steewbsd/Sichergo/docs/Sichergo.jpg

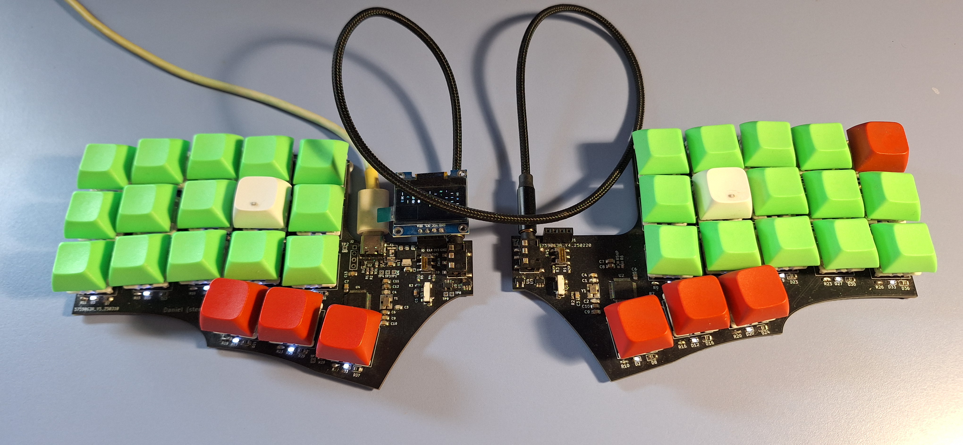
docs/Sichergo.jpg
