steewbsd/Sichergo/std/prot-right.dxf

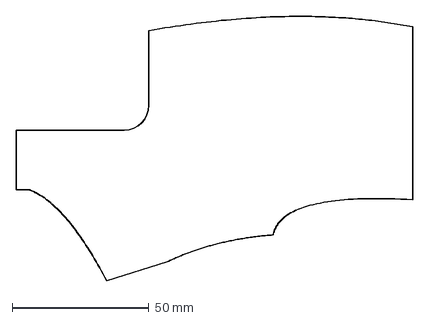
[picture p2: CAD file, 2025-11-02]
std/prot-right.dxf
144.7 x 96.5 mm
