steewbsd/Sichergo/std/prot-left.dxf

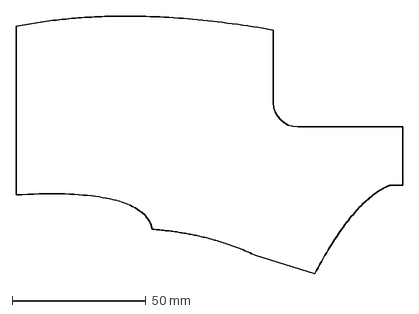
[picture p3: CAD file, 2025-11-02]
std/prot-left.dxf
144.7 x 96.5 mm
