steewbsd/Sichergo/std/sichergo-right.dxf

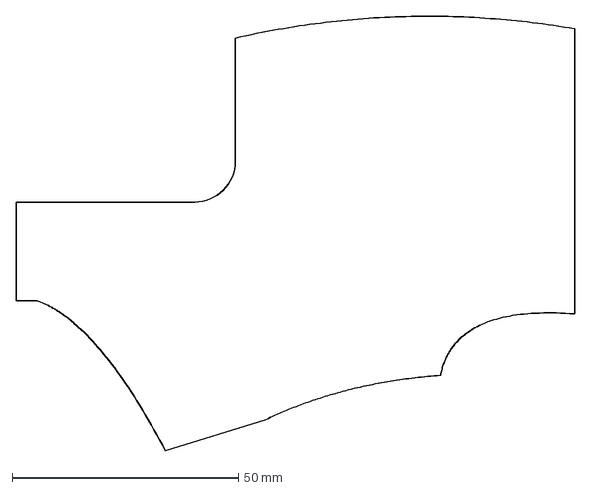
[picture p4: CAD file, 2025-11-02]
std/sichergo-right.dxf
123.4 x 96.1 mm
