steewbsd/Sichergo/sichergo-right/sichergo-right.kicad_pcb

## KiCad design sichergo-right/sichergo-right.kicad_pcb (2025-11-02)

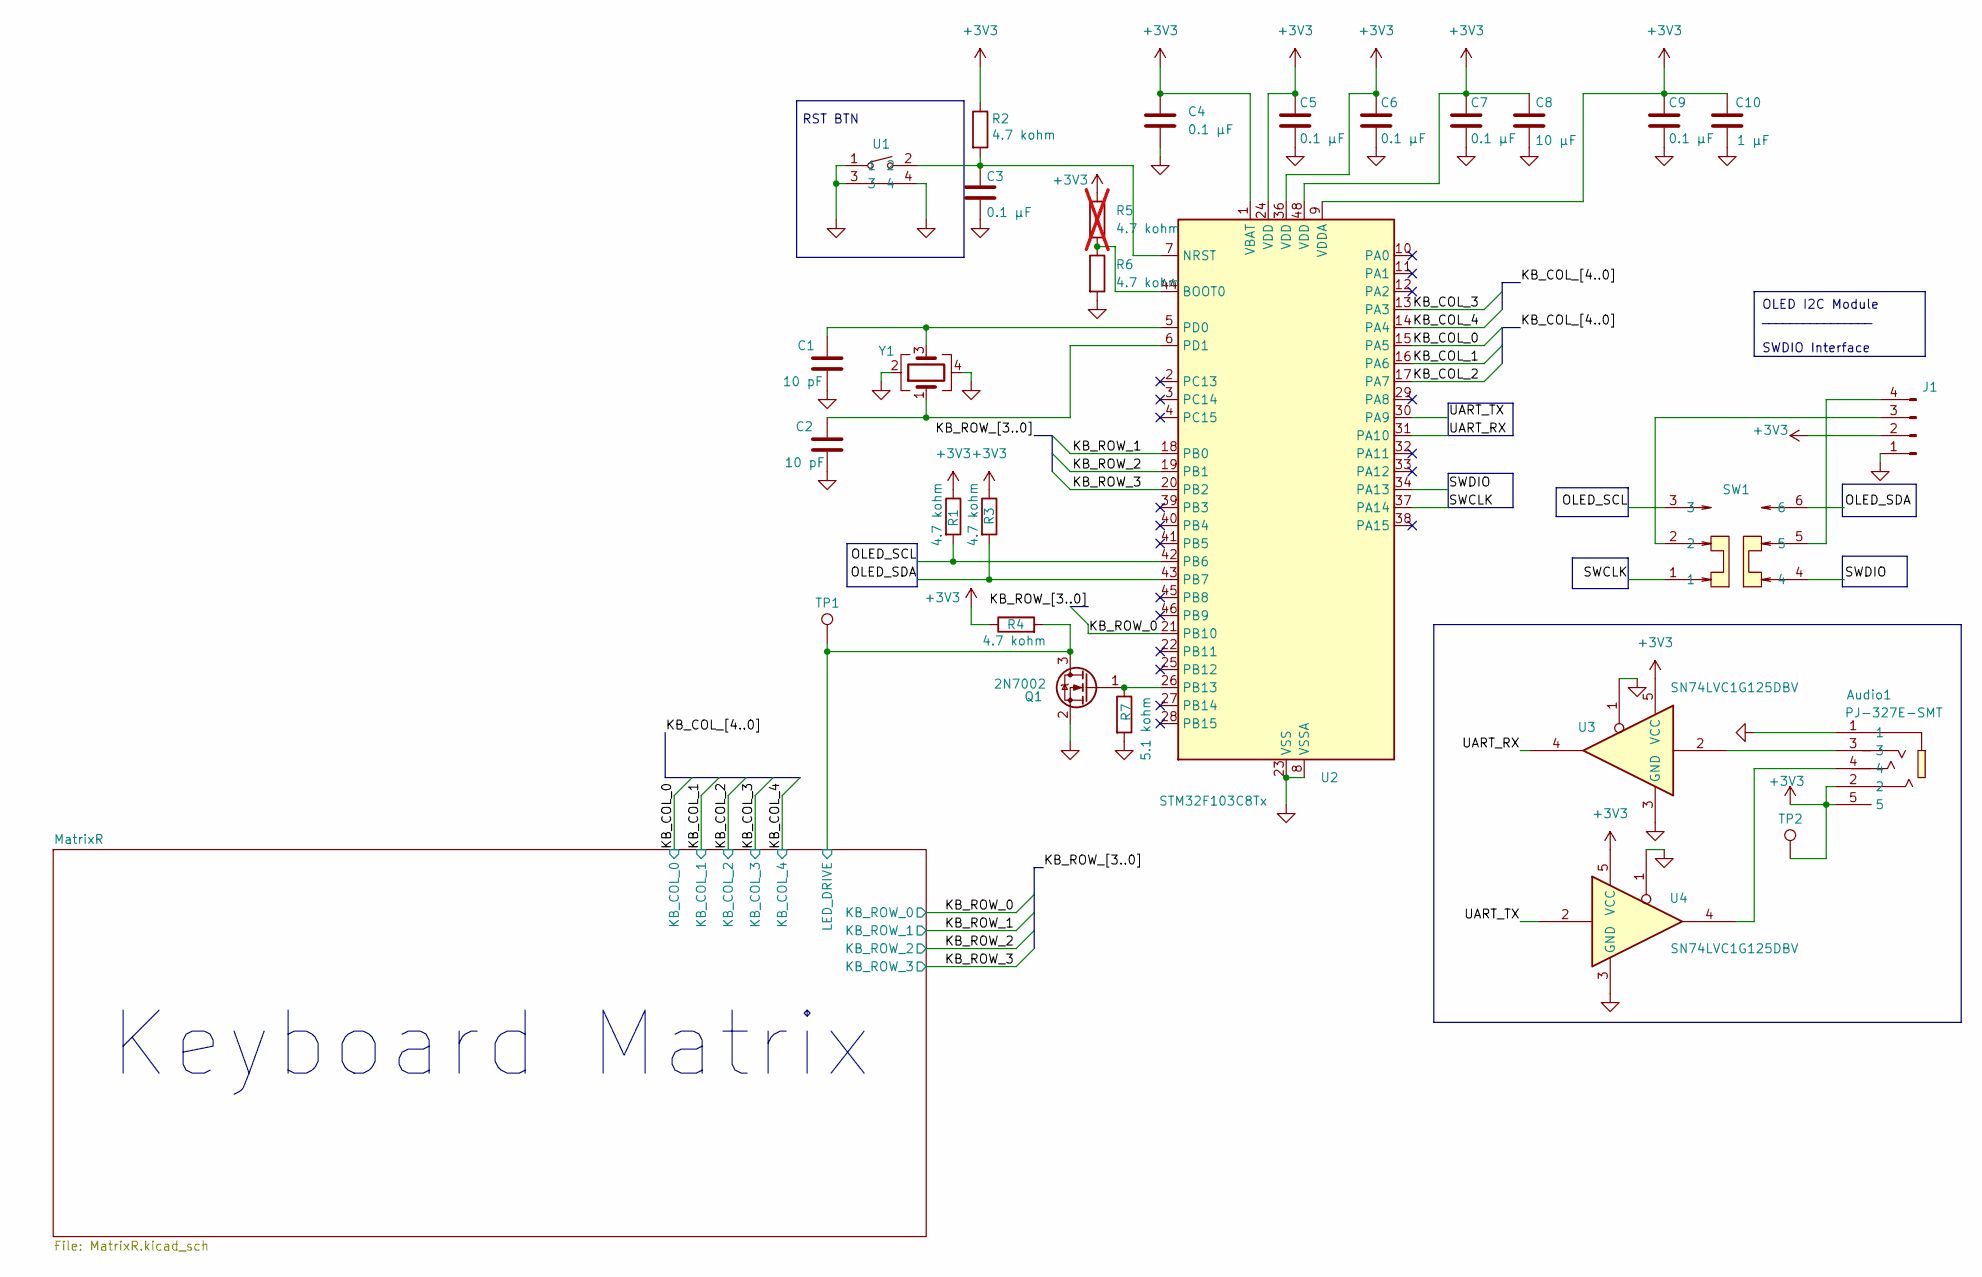
[picture p8: schematic sichergo-right.kicad_sch, Simple Keyboard]

Parts:
Audio1: PJ-327E-SMT; AUDIO-SMD_PJ-327E-SMT; LCSC Part C319105
C1, C2: 10 pF; C_0805_2012Metric_Pad1.18x1.45mm_HandSolder; Rated Voltage 50V; Tolerance 0.25pF
C3, C4, C5, C6, C7, C9: 0.1 µF; C_0805_2012Metric_Pad1.18x1.45mm_HandSolder; Rated Voltage 50V; Tolerance 10%
C8: 10 µF; C_0805_2012Metric_Pad1.18x1.45mm_HandSolder; Rated Voltage 16V; Tolerance 10%
C10: 1 µF; C_0805_2012Metric_Pad1.18x1.45mm_HandSolder; Rated Voltage 25V; Tolerance 10%
J1: Conn_01x04_Pin; PinSocket_1x04_P2.54mm_Horizontal
Q1: 2N7002; SOT-23_Handsoldering
R1, R2, R3, R4, R6: 4.7 kohm; R_0603_1608Metric_Pad0.98x0.95mm_HandSolder; Tolerance 1%
R5: 4.7 kohm; R_0603_1608Metric_Pad0.98x0.95mm_HandSolder; Tolerance 1%; not fitted
R7: 5.1 kohm; R_0603_1608Metric_Pad0.98x0.95mm_HandSolder; Tolerance 1%
SW1: MS-22C01-G010; SW-SMD_6P-L7.2-W3.5-P2.50-LS6.0-TL; LCSC Part C2837066
TP1, TP2: TestPoint; TestPoint_THTPad_1.0x1.0mm_Drill0.5mm
U1: YTS1C0033BBG01; SW-SMD_YIYUAN_YTS1C003XXX; LCSC Part C5188566
U2: STM32F103C8Tx; LQFP-48_7x7mm_P0.5mm
U3, U4: SN74LVC1G125DBV; SOT-23-5_HandSoldering
Y1: Crystal_GND24; Crystal_SMD_3225-4Pin_3.2x2.5mm_HandSoldering

Connections:
+3V3: Audio1.2, Audio1.5, C4.1, C5.1, C6.1, C7.1, C8.1, C9.1, C10.1, J1.2, R1.1, R2.1, R3.1, R4.1, R5.1, TP2.1, U2.1 (VBAT), U2.9 (VDDA), U2.24 (VDD), U2.36 (VDD), U2.48 (VDD), U3.5 (VCC), U4.5 (VCC)
/KB_COL_0: U2.15 (PA5); also elsewhere on the board
/KB_COL_1: U2.16 (PA6); also elsewhere on the board
/KB_COL_2: U2.17 (PA7); also elsewhere on the board
/KB_COL_3: U2.13 (PA3); also elsewhere on the board
/KB_COL_4: U2.14 (PA4); also elsewhere on the board
/KB_ROW_0: U2.21 (PB10); also elsewhere on the board
/KB_ROW_1: U2.18 (PB0); also elsewhere on the board
/KB_ROW_2: U2.19 (PB1); also elsewhere on the board
/KB_ROW_3: U2.20 (PB2); also elsewhere on the board
/MatrixR/LED_DRIVE: Q1.3 (D), R4.2, TP1.1; also elsewhere on the board
/OLED_SCL: R1.2, SW1.3, U2.42 (PB6)
/OLED_SDA: R3.2, SW1.6, U2.43 (PB7)
/SWCLK: SW1.1, U2.37 (PA14)
/SWDIO: SW1.4, U2.34 (PA13)
/UART_RX: U2.31 (PA10), U3.4
/UART_TX: U2.30 (PA9), U4.2
GND: Audio1.1, C1.2, C2.2, C3.2, C4.2, C5.2, C6.2, C7.2, C8.2, C9.2, C10.2, J1.1, Q1.2 (S), R6.2, R7.2, U1.1, U1.3, U1.4, U2.8 (VSSA), U2.23 (VSS), U2.35 (VSS), U2.47 (VSS), U3.1, U3.3 (GND), U4.1, U4.3 (GND), Y1.2, Y1.4; also elsewhere on the board
unnamed: Audio1.3, U3.2
unnamed: Audio1.4, U4.4
unnamed: J1.3, SW1.2
unnamed: J1.4, SW1.5
unnamed: Q1.1 (G), R7.1, U2.26 (PB13)
unnamed: R5.2, R6.1, U2.44 (BOOT0)
unnamed: C3.1, R2.2, U1.2, U2.7 (NRST)
unnamed: C1.1, U2.5 (PD0), Y1.3
unnamed: C2.1, U2.6 (PD1), Y1.1

Notes on the sheet:
OLED I2C Module ________________ SWDIO Interface
RST BTN
Keyboard Matrix

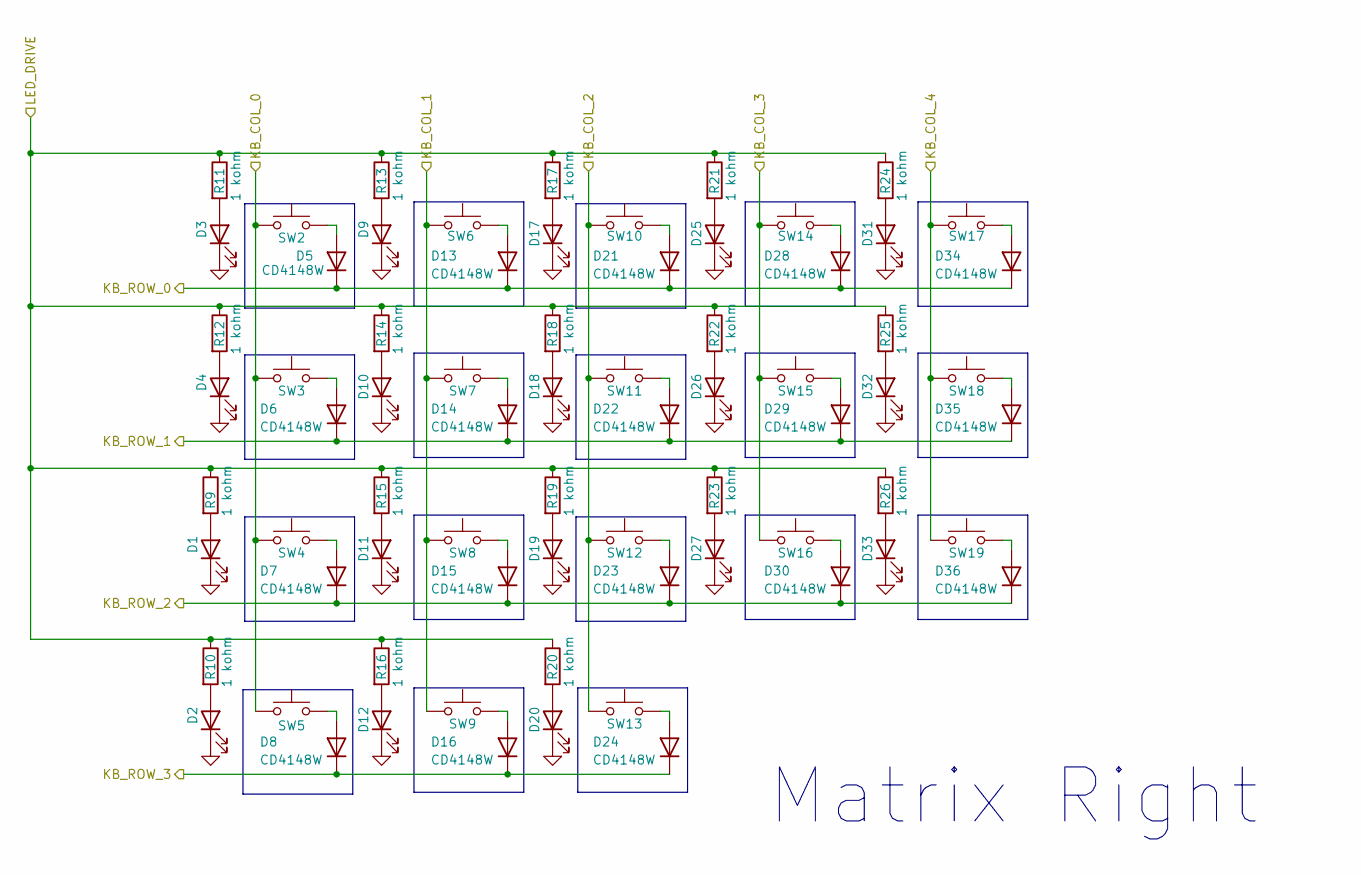
[picture p9: schematic MatrixR.kicad_sch, Simple Keyboard]

Parts:
D1, D2, D3, D4, D9, D10, D11, D12, D17, D18, D19, D20, D25, D26, D27, D31, D32, D33: LED; LED_0603_1608Metric_Pad1.05x0.95mm_HandSolder
D5, D6, D7, D8, D13, D14, D15, D16, D21, D22, D23, D24, D28, D29, D30, D34, D35, D36: CD4148W; D_0805_2012Metric_Pad1.15x1.40mm_HandSolder
R9, R10, R11, R12, R13, R14, R15, R16, R17, R18, R19, R20, R21, R22, R23, R24, R25, R26: 1 kohm; R_0603_1608Metric_Pad0.98x0.95mm_HandSolder; Tolerance 1%
SW2, SW3, SW4, SW5, SW6, SW7, SW8, SW9, SW10, SW11, SW12, SW13, SW14, SW15, SW16, SW17, SW18, SW19: SW_Push; Gateron_Milky_Yellow

Connections:
/KB_COL_0: SW2.1, SW3.1, SW4.1, SW5.1; also elsewhere on the board
/KB_COL_1: SW6.1, SW7.1, SW8.1, SW9.1; also elsewhere on the board
/KB_COL_2: SW10.1, SW11.1, SW12.1, SW13.1; also elsewhere on the board
/KB_COL_3: SW14.1, SW15.1, SW16.1; also elsewhere on the board
/KB_COL_4: SW17.1, SW18.1, SW19.1; also elsewhere on the board
/KB_ROW_0: D5.1 (K), D13.1 (K), D21.1 (K), D28.1 (K), D34.1 (K); also elsewhere on the board
/KB_ROW_1: D6.1 (K), D14.1 (K), D22.1 (K), D29.1 (K), D35.1 (K); also elsewhere on the board
/KB_ROW_2: D7.1 (K), D15.1 (K), D23.1 (K), D30.1 (K), D36.1 (K); also elsewhere on the board
/KB_ROW_3: D8.1 (K), D16.1 (K), D24.1 (K); also elsewhere on the board
/MatrixR/LED_DRIVE: R9.1, R10.1, R11.1, R12.1, R13.1, R14.1, R15.1, R16.1, R17.1, R18.1, R19.1, R20.1, R21.1, R22.1, R23.1, R24.1, R25.1, R26.1; also elsewhere on the board
GND: D1.1 (K), D2.1 (K), D3.1 (K), D4.1 (K), D9.1 (K), D10.1 (K), D11.1 (K), D12.1 (K), D17.1 (K), D18.1 (K), D19.1 (K), D20.1 (K), D25.1 (K), D26.1 (K), D27.1 (K), D31.1 (K), D32.1 (K), D33.1 (K); also elsewhere on the board
unnamed: D1.2 (A), R9.2
unnamed: D2.2 (A), R10.2
unnamed: D3.2 (A), R11.2
unnamed: D4.2 (A), R12.2
unnamed: D5.2 (A), SW2.2
unnamed: D6.2 (A), SW3.2
unnamed: D7.2 (A), SW4.2
unnamed: D8.2 (A), SW5.2
unnamed: D9.2 (A), R13.2
unnamed: D10.2 (A), R14.2
unnamed: D11.2 (A), R15.2
unnamed: D12.2 (A), R16.2
unnamed: D13.2 (A), SW6.2
unnamed: D14.2 (A), SW7.2
unnamed: D15.2 (A), SW8.2
unnamed: D16.2 (A), SW9.2
unnamed: D17.2 (A), R17.2
unnamed: D18.2 (A), R18.2
unnamed: D19.2 (A), R19.2
unnamed: D20.2 (A), R20.2
unnamed: D21.2 (A), SW10.2
unnamed: D22.2 (A), SW11.2
unnamed: D23.2 (A), SW12.2
unnamed: D24.2 (A), SW13.2
unnamed: D25.2 (A), R21.2
unnamed: D26.2 (A), R22.2
unnamed: D27.2 (A), R23.2
unnamed: D28.2 (A), SW14.2
unnamed: D29.2 (A), SW15.2
unnamed: D30.2 (A), SW16.2
unnamed: D31.2 (A), R24.2
unnamed: D32.2 (A), R25.2
unnamed: D33.2 (A), R26.2
unnamed: D34.2 (A), SW17.2
unnamed: D35.2 (A), SW18.2
unnamed: D36.2 (A), SW19.2

Notes on the sheet:
Matrix Right

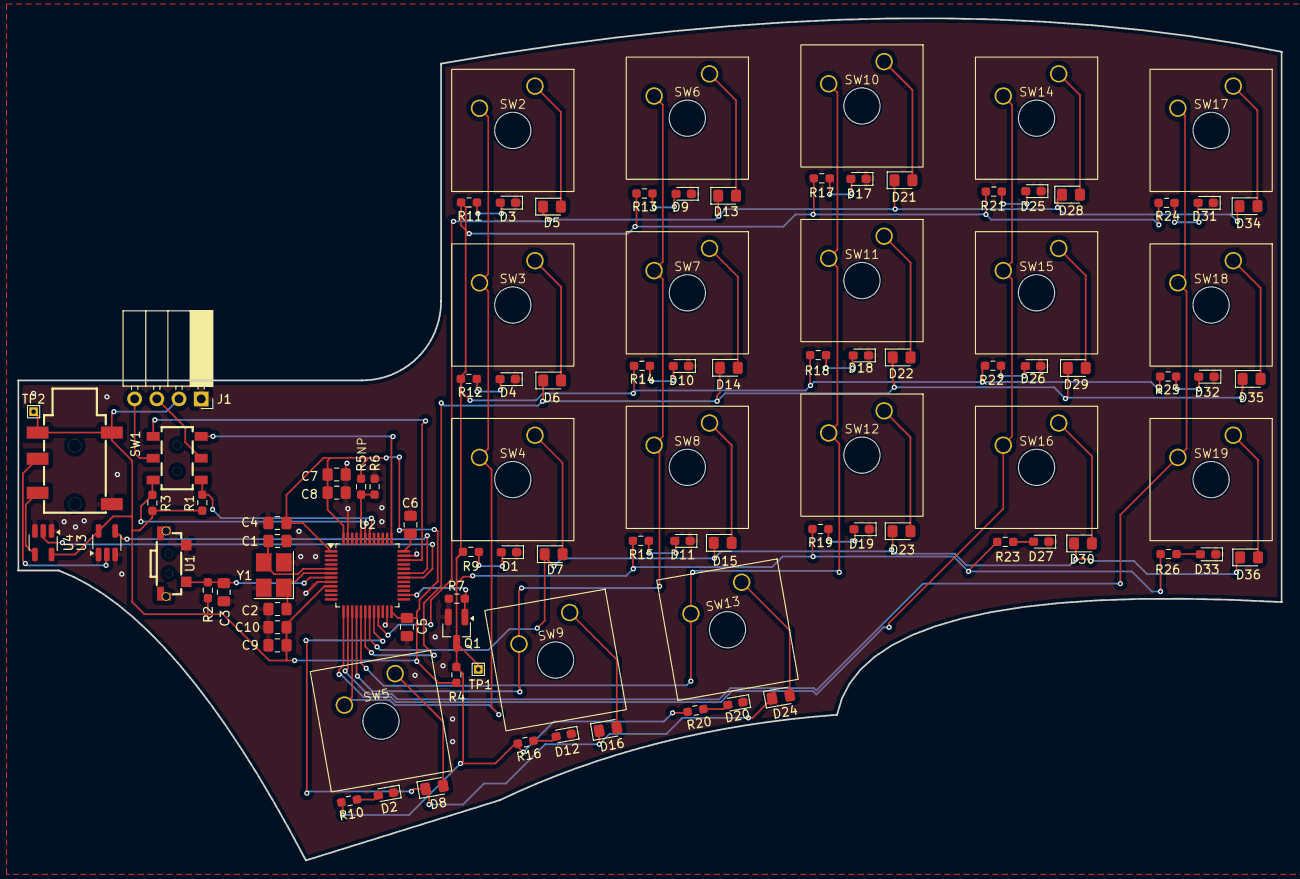
[picture p10: board sichergo-right.kicad_pcb from above]

Board: 2 copper layers, 144.7 x 96.5 mm, 100 parts (0 on the bottom side), 63 nets.
