steewbsd/Sichergo/sichergo/sichergo.kicad_pcb

## KiCad design sichergo/sichergo.kicad_pcb (2025-02-13)

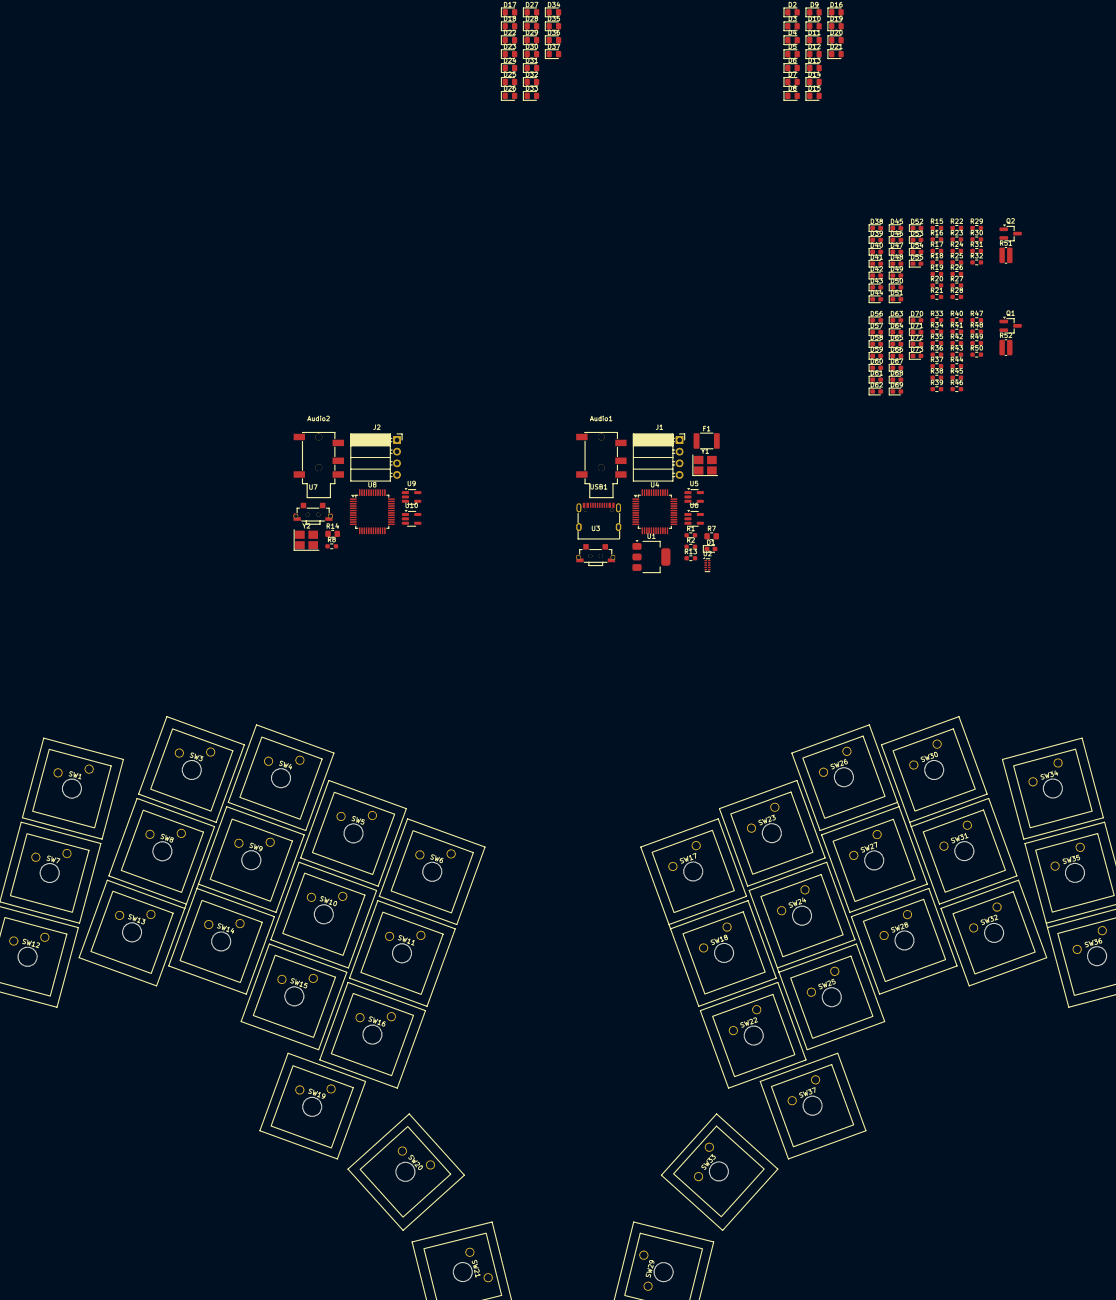
[picture p11: board sichergo.kicad_pcb from above]

Board: 2 copper layers, 173 parts (0 on the bottom side), 116 nets, no tracks yet.

Parts:
Audio1, Audio2: PJ-327E-SMT; AUDIO-SMD_PJ-327E-SMT
D1: CPDUR5V0HE-HF; D_0603_1608Metric_Pad1.05x0.95mm_HandSolder
D2, D3, D4, D5, D6, D7, D8, D9, D10, D11, D12, D13, D14, D15, D16, D17, D18, D19, D20, D21, D22, D23, D24, D25, D26, D27, D28, D29, D30, D31, D32, D33, D34, D35, D36, D37: CD4148W; D_0805_2012Metric_Pad1.15x1.40mm_HandSolder
D38, D39, D40, D41, D42, D43, D44, D45, D46, D47, D48, D49, D50, D51, D52, D53, D54, D55, D56, D57, D58, D59, D60, D61, D62, D63, D64, D65, D66, D67, D68, D69, D70, D71, D72, D73: LED; LED_0603_1608Metric_Pad1.05x0.95mm_HandSolder
F1: 1812L050/30PR; Fuse_1812_4532Metric_Pad1.30x3.40mm_HandSolder
J1, J2: Conn_01x04_Pin; PinSocket_1x04_P2.54mm_Horizontal
Q1, Q2: 2N7002; SOT-23_Handsoldering
R1, R13: 5.1 kohm; R_0603_1608Metric_Pad0.98x0.95mm_HandSolder
R2, R8: 4.7 kohm; R_0603_1608Metric_Pad0.98x0.95mm_HandSolder
R7, R14: 100 ohm; R_0805_2012Metric_Pad1.20x1.40mm_HandSolder
R15, R16, R17, R18, R19, R20, R21, R22, R23, R24, R25, R26, R27, R28, R29, R30, R31, R32, R33, R34, R35, R36, R37, R38, R39, R40, R41, R42, R43, R44, R45, R46, R47, R48, R49, R50: 1 kohm; R_0603_1608Metric_Pad0.98x0.95mm_HandSolder
R51, R52: 5.1 kohm; R_0612_1632Metric_Pad1.18x3.40mm_HandSolder
SW1, SW3, SW4, SW5, SW6, SW7, SW8, SW9, SW10, SW11, SW12, SW13, SW14, SW15, SW16, SW17, SW18, SW19, SW20, SW21, SW22, SW23, SW24, SW25, SW26, SW27, SW28, SW29, SW30, SW31, SW32, SW33, SW34, SW35, SW36, SW37: SW_Push; Gateron_Milky_Yellow
U1: AZ1117-3.3; SOT-223-3_TabPin2
U2: TPD4E05U06DQA; USON-10_2.5x1.0mm_P0.5mm
U3, U7: YTS1C0033BBG01; SW-SMD_YIYUAN_YTS1C003XXX
U4, U8: STM32F103C8Tx; LQFP-48_7x7mm_P0.5mm
U5, U6, U9, U10: SN74LVC1G125DBV; SOT-23-5_HandSoldering
USB1: TYPE-C 16PIN 2MD(073); USB-C-SMD_TYPE-C-6PIN-2MD-073
Y1, Y2: Crystal_GND24; Crystal_SMD_3225-4Pin_3.2x2.5mm_HandSoldering

Connections:
+3V3: Audio1.2, Audio1.5, Audio2.2, Audio2.5, J1.2, J2.2, Q1.3 (D), Q2.3 (D), R2.1, R8.1, R15.1, R16.1, R17.1, R18.1, R19.1, R20.1, R21.1, R22.1, R23.1, R24.1, R25.1, R26.1, R27.1, R28.1, R29.1, R30.1, R31.1, R32.1, R33.1, R34.1, R35.1, R36.1, R37.1, R38.1, R39.1, R40.1, R41.1, R42.1, R43.1, R44.1, R45.1, R46.1, R47.1, R48.1, R49.1, R50.1, U1.2 (VO), U4.1 (VBAT), U4.9 (VDDA), U4.24 (VDD), U4.36 (VDD), U4.48 (VDD), U5.5 (VCC), U6.5 (VCC), U8.1 (VBAT), U8.9 (VDDA), U8.24 (VDD), U8.36 (VDD), U8.48 (VDD), U9.5 (VCC), U10.5 (VCC)
/KBD_L/D+: U2.1 (D1+), USB1.6 (DP1), USB1.8 (DP2)
/KBD_L/D-: U2.2 (D1-), USB1.5 (DN2), USB1.7 (DN1)
/KBD_L/KB_COL_0: SW1.1, SW7.1, SW12.1, U4.10 (PA0)
/KBD_L/KB_COL_1: SW3.1, SW8.1, SW13.1, U4.11 (PA1)
/KBD_L/KB_COL_2: SW4.1, SW9.1, SW14.1, SW19.1, U4.12 (PA2)
/KBD_L/KB_COL_3: SW5.1, SW10.1, SW15.1, SW20.1, U4.13 (PA3)
/KBD_L/KB_COL_4: SW6.1, SW11.1, SW16.1, SW21.1, U4.14 (PA4)
/KBD_L/KB_ROW_0: D2.1 (K), D3.1 (K), D4.1 (K), D5.1 (K), D6.1 (K), U4.15 (PA5)
/KBD_L/KB_ROW_1: D7.1 (K), D8.1 (K), D9.1 (K), D10.1 (K), D11.1 (K), U4.16 (PA6)
/KBD_L/KB_ROW_2: D12.1 (K), D13.1 (K), D14.1 (K), D15.1 (K), D16.1 (K), U4.17 (PA7)
/KBD_L/KB_ROW_3: D19.1 (K), D20.1 (K), D21.1 (K), U4.29 (PA8)
/KBD_L/UART_RX: U4.31 (PA10), U6.4
/KBD_L/UART_TX: U4.30 (PA9), U5.2
/KBD_L/VBUS: D1.2 (A2), F1.1, USB1.2 (VBUS), USB1.11 (VBUS)
/KBD_R/KB_COL_0: SW17.1, SW18.1, SW22.1, SW29.1, U8.10 (PA0)
/KBD_R/KB_COL_1: SW23.1, SW24.1, SW25.1, SW33.1, U8.11 (PA1)
/KBD_R/KB_COL_2: SW26.1, SW27.1, SW28.1, SW37.1, U8.12 (PA2)
/KBD_R/KB_COL_3: SW30.1, SW31.1, SW32.1, U8.13 (PA3)
/KBD_R/KB_COL_4: SW34.1, SW35.1, SW36.1, U8.14 (PA4)
/KBD_R/KB_ROW_4: D17.1 (K), D23.1 (K), D26.1 (K), D30.1 (K), D34.1 (K), U8.15 (PA5)
/KBD_R/KB_ROW_5: D18.1 (K), D24.1 (K), D27.1 (K), D31.1 (K), D35.1 (K), U8.16 (PA6)
/KBD_R/KB_ROW_6: D22.1 (K), D25.1 (K), D28.1 (K), D32.1 (K), D36.1 (K), U8.17 (PA7)
/KBD_R/KB_ROW_7: D29.1 (K), D33.1 (K), D37.1 (K), U8.29 (PA8)
/KBD_R/UART_RX: U8.31 (PA10), U9.4
/KBD_R/UART_TX: U8.30 (PA9), U10.2
GND: D1.1 (A1), D38.1 (K), D39.1 (K), D40.1 (K), D41.1 (K), D42.1 (K), D43.1 (K), D44.1 (K), D45.1 (K), D46.1 (K), D47.1 (K), D48.1 (K), D49.1 (K), D50.1 (K), D51.1 (K), D52.1 (K), D53.1 (K), D54.1 (K), D55.1 (K), D56.1 (K), D57.1 (K), D58.1 (K), D59.1 (K), D60.1 (K), D61.1 (K), D62.1 (K), D63.1 (K), D64.1 (K), D65.1 (K), D66.1 (K), D67.1 (K), D68.1 (K), D69.1 (K), D70.1 (K), D71.1 (K), D72.1 (K), D73.1 (K), J1.1, J2.1, Q1.2 (S), Q2.2 (S), R1.2, R7.2, R13.2, R14.2, R51.2, R52.2, U1.1 (GND), U2.3 (GND), U2.8 (GND), U3.1, U3.3, U3.4, U4.8 (VSSA), U4.23 (VSS), U4.35 (VSS), U4.47 (VSS), U5.1, U5.3 (GND), U6.1, U6.3 (GND), U7.1, U7.3, U7.4, U8.8 (VSSA), U8.23 (VSS), U8.35 (VSS), U8.47 (VSS), U9.1, U9.3 (GND), U10.1, U10.3 (GND), USB1.1 (GND), USB1.12 (GND), USB1.13 (SHELL), USB1.14 (SHELL), Y1.2, Y1.4, Y2.2, Y2.4
unnamed: Audio1.1, R7.1
unnamed: Audio1.3, U5.4
unnamed: Audio1.4, U6.2
unnamed: Audio2.1, R14.1
unnamed: Audio2.3, U9.2
unnamed: Audio2.4, U10.4
unnamed: D2.2 (A), SW1.2
unnamed: D3.2 (A), SW3.2
unnamed: D4.2 (A), SW4.2
unnamed: D5.2 (A), SW5.2
unnamed: D6.2 (A), SW6.2
unnamed: D7.2 (A), SW7.2
unnamed: D8.2 (A), SW8.2
unnamed: D9.2 (A), SW9.2
unnamed: D10.2 (A), SW10.2
unnamed: D11.2 (A), SW11.2
unnamed: D12.2 (A), SW12.2
unnamed: D13.2 (A), SW13.2
unnamed: D14.2 (A), SW14.2
unnamed: D15.2 (A), SW15.2
unnamed: D16.2 (A), SW16.2
unnamed: D17.2 (A), SW17.2
unnamed: D18.2 (A), SW18.2
unnamed: D19.2 (A), SW19.2
unnamed: D20.2 (A), SW20.2
unnamed: D21.2 (A), SW21.2
unnamed: D22.2 (A), SW22.2
unnamed: D23.2 (A), SW23.2
unnamed: D24.2 (A), SW24.2
unnamed: D25.2 (A), SW25.2
unnamed: D26.2 (A), SW26.2
unnamed: D27.2 (A), SW27.2
unnamed: D28.2 (A), SW28.2
unnamed: D29.2 (A), SW29.2
unnamed: D30.2 (A), SW30.2
unnamed: D31.2 (A), SW31.2
unnamed: D32.2 (A), SW32.2
unnamed: D33.2 (A), SW33.2
unnamed: D34.2 (A), SW34.2
unnamed: D35.2 (A), SW35.2
unnamed: D36.2 (A), SW36.2
unnamed: D37.2 (A), SW37.2
unnamed: D38.2 (A), R15.2
unnamed: D39.2 (A), R16.2
unnamed: D40.2 (A), R17.2
unnamed: D41.2 (A), R23.2
unnamed: D42.2 (A), R22.2
unnamed: D43.2 (A), R20.2
unnamed: D44.2 (A), R18.2
unnamed: D45.2 (A), R19.2
unnamed: D46.2 (A), R27.2
unnamed: D47.2 (A), R28.2
unnamed: D48.2 (A), R21.2
unnamed: D49.2 (A), R26.2
unnamed: D50.2 (A), R25.2
unnamed: D51.2 (A), R24.2
unnamed: D52.2 (A), R32.2
unnamed: D53.2 (A), R31.2
unnamed: D54.2 (A), R30.2
unnamed: D55.2 (A), R29.2
unnamed: D56.2 (A), R34.2
unnamed: D57.2 (A), R35.2
unnamed: D58.2 (A), R50.2
unnamed: D59.2 (A), R41.2
unnamed: D60.2 (A), R40.2
unnamed: D61.2 (A), R39.2
unnamed: D62.2 (A), R42.2
unnamed: D63.2 (A), R49.2
unnamed: D64.2 (A), R48.2
unnamed: D65.2 (A), R43.2
unnamed: D66.2 (A), R38.2
unnamed: D67.2 (A), R37.2
unnamed: D68.2 (A), R44.2
unnamed: D69.2 (A), R47.2
unnamed: D70.2 (A), R46.2
unnamed: D71.2 (A), R45.2
unnamed: D72.2 (A), R36.2
unnamed: D73.2 (A), R33.2
unnamed: Q1.1 (G), R52.1, U8.26 (PB13)
unnamed: Q2.1 (G), R51.1, U4.26 (PB13)
unnamed: F1.2, U1.3 (VI)
unnamed: R2.2, U3.2, U4.7 (NRST)
unnamed: U4.5 (PD0), Y1.3
unnamed: U4.6 (PD1), Y1.1
unnamed: R8.2, U7.2, U8.7 (NRST)
unnamed: U8.5 (PD0), Y2.3
unnamed: U8.6 (PD1), Y2.1
unnamed: R1.1, USB1.4 (CC1)
unnamed: R13.1, USB1.10 (CC2)
