steewbsd/Sichergo/(commit log)

2025-02-10 First commit, halfway in the schematic
    [KbdL.kicad_sch, KbdR.kicad_sch, MatrixL.kicad_sch, MatrixR.kicad_sch, sichergo.kicad_pcb, sichergo.kicad_sch, typaBLE.csv]
2025-02-12 Added initial matrix and UART
    [InterTypeC.kicad_sch, KbdL.kicad_sch, KbdR.kicad_sch, sichergo.kicad_pcb]
2025-02-12 Added footprints to switches
    [KbdL.kicad_sch, KbdR.kicad_sch, MatrixL.kicad_sch, MatrixR.kicad_sch, sichergo.kicad_pcb]
2025-02-12 Add gateron footprint
2025-02-13 Add backlight and switch connections
    [KbdL.kicad_sch, KbdR.kicad_sch, MatrixL.kicad_sch, MatrixR.kicad_sch, sichergo.kicad_pcb]
2025-02-13 Pre finish layout
    [KbdL.kicad_sch, KbdR.kicad_sch, MatrixL.kicad_sch, MatrixR.kicad_sch]
2025-02-13 Start layout
    [KbdL.kicad_sch, sichergo.kicad_pcb]
2025-02-14 Split design in two PCBs and remake layout
    [InterTypeC.kicad_sch, MatrixL.kicad_sch, MatrixR.kicad_sch, all-board.FCStd, imola.dxf, left-trimmed.dxf, right-Sketch.dxf, right.FCStd]
2025-02-15 Route left side
    [sichergo-left.kicad_pcb, sichergo-left.kicad_sch]
2025-02-15 Reroute everything
    [sichergo-left-B_Cu.gbr, sichergo-left-B_Mask.gbr, sichergo-left-B_Paste.gbr, sichergo-left-B_Silkscreen.gbr, sichergo-left-Edge_Cuts.gbr, sichergo-left-F_Cu.gbr, sichergo-left-F_Mask.gbr, sichergo-left-F_Paste.gbr]
2025-02-15 FInish routing, missing 3V3 net
    [sichergo-left.kicad_pcb]
2025-02-15 Finish 3V3
    [sichergo-left.kicad_pcb]
2025-02-15 Finish routing LEFT side
    [sichergo-left-B_Cu.gbr, sichergo-left-B_Mask.gbr, sichergo-left-B_Paste.gbr, sichergo-left-B_Silkscreen.gbr, sichergo-left-Edge_Cuts.gbr, sichergo-left-F_Cu.gbr, sichergo-left-F_Mask.gbr, sichergo-left-F_Paste.gbr]
2025-02-16 Remake entire shape
    [MatrixR.kicad_sch, prot-left.dxf, sichergo-left-B_Cu.dxf, sichergo-left-B_Mask.dxf, sichergo-left-B_Paste.dxf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]
2025-02-16 Finish routing new LEFT
    [prot-left.dxf, sichergo-left-B_Cu.dxf, sichergo-left-B_Mask.dxf, sichergo-left-B_Paste.dxf, sichergo-left-B_Silkscreen.dxf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]
2025-02-16 Pre DRC
    [sichergo-left.kicad_pcb]
2025-02-16 Finish routing redesign
    [sichergo-left.kicad_pcb]
2025-02-16 Add right outline
    [all-board.FCStd, imola.dxf, left-trimmed.dxf, prot-right.dxf, right-Sketch.dxf, right.FCStd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]
2025-02-17 Fix keyboard layout size
    [MatrixR.kicad_sch, prot-left.dxf, sichergo-left.kicad_pcb, sichergo-left.kicad_sch, sichergo-right.kicad_pcb, sichergo-right.kicad_sch]
2025-02-17 Fix copper pour shape
    [sichergo-left.kicad_pcb]
2025-02-19 Start placement of right side
    [prot-right.dxf, sichergo-right.kicad_pcb, sichergo-right.kicad_sch]
2025-02-19 Finish routing right side
    [sichergo-right.kicad_pcb, sichergo-right.kicad_sch]
2025-03-09 fix left side USB C
    [MatrixL.kicad_sch, sichergo-left.csv, sichergo-left.kicad_pcb, sichergo-left.kicad_sch, sichergo-right.kicad_pcb, sichergo-right.kicad_sch]
2025-03-14 add preliminary code for PWM with the PAC
2025-03-14 fw: first working breathing LEDs
2025-03-16 fw: finish PWM breathing pattern
2025-03-16 hw: update fix
    [sichergo-left.kicad_pcb]
2025-03-23 fw: keyboard reports, but wrong matrix
    [main.rs]
2025-03-25 fw: working both sides, leds react on touch
